reiniciosoftware1/LockPic/README.md

# LockPic
Programa cerradura para microcontrolador PIC
