reiniciosoftware1/LockPic/Trunk/Documentos/Circuito/Circuito_28P_V_1.1/LocPic_28P - CADCAM Mechanical 1.TXT

G04 PROTEUS RS274X GERBER FILE*
%FSLAX24Y24*%
%MOIN*%
%ADD24C,0.0080*%
G54D24*
X+0Y-866D02*
X+47559Y-866D01*
X+47559Y+21968D01*
X+0Y+21968D01*
X+0Y-866D01*
M00*
