reiniciosoftware1/LockPic/Trunk/Documentos/Circuito/Documentos/V_1_0/Documentacion.odt

TARJETA LOCKPICK V 1.0

CONTROL DE CAMBIOS DOCUMENTO VERSION 1.0.

19-04-2022 | Creacion primera version
29-04-2022 | Correcion parametros comunicacion y comandos
02-05-2022 | Inckuir ejemplo configuracion cerradura 3

# COMENTARIOS

1. Todos los pines pasadores entre capas se deben soldar primero, especialmente el que esta debajo del conector J1.
2. La puerta 1 es la de la boveda que se controla con el actuador negro.
3. La puerta 3 es la puerta de mantenimiento que se controla con el solenoide.

# FUENTES DE VOLTAJE

ID | ESPECIFICACIONES | DISPOSTIVOS CONECTADOS
F1 | 5V/2A | Tarjeta cerradura ( PIC, buzzer )
F2 | 12V/2A | Tarjeta cerradura ( Actuador y solenoide )
F3 | 24V/4A | Aceptador de billetes

IMPORTANTE todas las salidas -V ( 0VDC ) de las fuentes deben estar interconectadas para tener comun 0V.

# CONECTORES

ID | USO | PINES
J1 | Actuador cerradura negro | 1- Salida para dar orden al actuador de abrir puerta 2- Salida para dar orden al actuador de cerrar la puerta 3- Entrada para saber si el actuador esta en posicion de abierto 4- Entrada para saber si el actuador esta en posicion de cerrado 5- Salida para dar orden detener actuador 6- Salida sensor magnetico interno del actuador 7- Salida 12 VDC 8- Salida 0 VDC 9- Libre
J2 | Sensor bloqueada manija boveda | 1- Entrada pin comun del sensor 0V 2- Entrada pin NA del sensor
J3 | Sensor cerrada puerta boveda | 1- Entrada pin comun del sensor 0V 2- Entrada pin NA del sensor
J4 | Sensor bloqueada manija puerta mantenimiento ( DEBE ESTAR SOLDADO PERO NO SE USA) | 1- Entrada pin comun del sensor 0V 2- Entrada pin NA del sensor
J5 | Sensor cerrada puerta matenimiento | 1- Entrada pin comun del sensor 0V 2- Entrada pin NA del sensor
J6 | Salida para el solenoide de la puerta mantenimiento | 1- Salida +V 2- Salida -V
J7 | Fuentes de alimentacion | 1- Entrada 0 VDC 2- Entrada 5 VDC ( Alimenta el PIC) 3- Entrada 12 VDC ( Alimenta el actuador y el solenoide )
J8 | Comunicacion serial con el computador | 1- Salida 0 VDC. 2- Salida TX datos. 3- Entrada RX datos.

# CABLEADO

Los cables que van a sensores que detectan el estado de cerrado de las puertas o de las manijas, pueden ser magenticos o interruptores ( Finales de carrera ), en ambos casos los terminales usados son el Comun y el Normalmente abierto ( NA).

DESTINO EN LA TARJETA | USO | PINES
J1 | Actuador cerradura negro | Se solda cada cable segun el color en los pines del conector DB9 hembra: 1- Amarillo 2- Cafe 3- Verde 4- Azul 5- Blanco 6- Gris 7- Rojo 8- Negro 9- Libre
J2 | Sensor bloqueada manija boveda | 1- Comun del sensor 2- NA del sensor
J3 | Sensor cerrada puerta boveda | 1- Comun del sensor 2- NA del sensor
J4 | Sensor bloqueada manija puerta mantenimiento ( DEBE ESTAR SOLDADO PERO NO SE USA) | No esta instalado
J5 | Sensor cerrada puerta matenimiento | 1- Comun del sensor 2- NA del sensor
J6 | Salida para el solenoide de la puerta mantenimiento | 1- +V del solenoide ( Posiblemente cable rojo) 2- -V del solenoide ( Posiblemente cable negro )
J7 | Fuentes de alimentacion | 1- Cable a 0VDC comun de las fuentes. 2- Cable a +V fuende de 5 VDC 3- Cable a +V fuende de 12 VDC
J8 | Comunicacion serial con el computador | En el extremo que va al computador debe ir a un DB9 Hembra. 1- al pin 5 del DB9 ( es el 0V del computador) 2- al pin 2 del DB9 ( es el RX del computador) 3- al pin 3 del DB9 ( es el TX del computador).

# LISTA DE COMPONENTES

CANTIDAD | DETALLE | COMPRADA
1 | Base para integrado 28 pines | Sigma
1 | PIC 18F252 | Sigma
1 | Base para integrado 16 pines | Sigma
1 | Max 232CPE | Sigma
8 | Resistencias 10K - 1/4W
1 | Resistencia 1K - 1/4W | Sigma
1 | Resistencia 2.2K - 1/4W
1 | Resistencia 510 – 1/4W ( o valor mas cercano)
2 | Resistencia 330 - 1/4W
2 | Transistor BD136 | Sigma
1 | Transistor BD135
1 | Transistor TIP122
5 | Capacitores electroliticos 1uF ( 25V o 50V) | Sigma
2 | Capacitores ceramicos 22pF
2 | Capacitores ceramicos 100nF ( 104)
1 | Cristal 20MHz | Sigma
1 | Buzzer 5V o 9V ( Ver tamano quepa en el impreso) | Sigma
1 | LED 5mm ( El LED va con cables, NO soldado en el impreso ) | Sigma
1 | Porta LED 5mm para chasis ( En el local del segundo piso frente al que venden tornilleria venden unos metalicos como a $500 )
5 | Conectores verde para impreso de 2Pines | Sigma
2 | Conectores verdes para impreso de 3Pines | Sigma
1 | Conector DB9 Macho para impreso
5 | Conectores verdes para cable de 2pines | Sigma
2 | Conectores verde para cable de 2 pines | Sigma
1 | Conector DB9 Hembra para cable | Sigma
1 | Carcasa DB9 | Sigma
XX | Cable diferentes colores, teniendo encuenta que: El cable de comunicacion serial entre el computador y la tarjeta debe ser de 1metro de largo.
1 | Caja plastica para el impreso
4 | Juegos de soportes para impreso con tornillo y tuerca, para sujetar el impreso al piso de la caja
2 | Sensores magneticos o finales de carrera para detectar apertura de puertas
2 | Sensores magenticos o finales de carrera para detectar manija bloqueo de puertas.
15metro | Termo encogible de 3mm
15metro | Termo encogible de 5mm
15metro | Termo encogible de 8mm ( para proteger los cables )
1 paquete de 100 | Amarreplastico de 10cm ( aprox)

# PREPARACION

1. Verificacion antes de encender las fuente que no haya corto circuito.
2. Programar el PIC con la version del programa.
3. Instalar el PIC en la tarjeta y encender fuente de 5V y 12V.
4. Ejecutar el proceso de inicializacion de la cerradura.

# PRUEBAS

1. Cuando es energizada la tarjeta a 5V, el LED debe parpadear o quedar encendido.
2. Cuando es energizada la tarjeta a 5V el buzzer debe emitir un tono corto.
3. Ejecutar comando de apertura de puerta 1, debe bajar el pestillo del actuador negro
4. Ejecturar comando de cierre puerta 2, debe subir el pestillo del actuador negro
5. Ejecutar comando de apertura solenoide, debe contraerse el pestillo del solenoide por 3 Segundos y luego automaticamente volver a salir el pestillo.

# COMANDOS

Desde un computador con Windows, usando el programa Serial Port Utility, configurar el puerto serial a 9600 bps, 8bits, 1bit stop, paridad par ( Even ). Configurar transmision y recepcion de datos en formato HEX.

Luego conectar el cable serial entre la tarjeta y el computador y encender la fuente de 5V y 12V.

## INICIALIZACION DE LA CERRADURA

Cada vez que se programe el PIC se borra la memoria EEPROM donde esta la configuracion de las dos cerraduras, por lo que siempre luego de programado se debe ejecutar el siguiente proceso:

1. Enviar la trama: 03 08 42 00 73 01 02 03 04 3D
  Respuesta: 03 03 42 A0 E1
2. Enviar la trama: 03 08 42 02 73 01 02 03 04 3F
  Respuesta: 03 03 42 A0 E1

## APERTURA CERRADURAS

Para abrir la cerradura de la boveda, enviar el comando: 03 07 10 01 01 02 03 04 12

Respuesta: 03 03 10 A0 B3

Para abrir la cerradura de mantenimiento, enviar el comando: 03 07 10 03 01 02 03 04 10

Respuesta: 03 03 10 A0 B3

## CIERRE CERRADURAS

Para las cerraduras tipo solenoide se usa el mismo comando de apertura en caso de necesitar cerrar la puerta, aunque fisicamente solo con empujar la puerta el pestillo queda bloqueando la puerta.

Por otro lado, la cerradura de actuador lineal, requiere un comando diferente para que el pestillo salga y quede en la posicion de bloquear puerta, asi que el comando para cerrar la boveda es:

Enviar comando: 03 07 11 01 01 02 03 04 13

Respuesta: 03 03 10 A0 B3

## LECTURA SENSORES

La lectura del estado de los sensores, se obtiene al ejecutar el comando en el byte XX, donde cada bit representa el estado de cada sensor de la correspondiente puerta:

POSICION BIT | INTERPRETACION
7 | No usado
6 | No usado
5 | Para el actuador negro: 1- Pestillo adentro 0- Pestillo no adentro
4 | Para el actuador negro: 1- Pestillo completamente afuera 0- Pestillo no completo afuera
3 | No usado
2 | No usado
1 | Sensor de manija 1- Desbloqueada 0- Bloqueada
0 | Sensor puerta 1- Puerta abierta 0- Puerta cerrada

Para obtener el estado de los sensores puerta boveda enviar

comando: 03 05 20 01 22

Respuesta: 03 04 20 A0 XX B7

Para obtener el estado de los sensores de la puerta mantenimiento enviar

comando: 03 03 20 02 21

Respuesta: 03 04 20 A0 XX B7
