reiniciosoftware1/LockPic/Branches/README.md

# LockManager
Progama controlador de cerraduras
