reiniciosoftware1/LockPic/Trunk/Documentos/Diseno.odt

CERRADURA V2.0

Hay dos tipos de cerradura: A ( actuador lineal negro – Griego) B ( Lagart – Solenoide)

Cada cerradura tiene un conjunto de pines de salida para energizarla segun su logica de operacion, y otros pines para leer las señales de interruptores.

Cerradura tipo A: es la compuesta por el pestillo motorizado, que requiere mediante un pulso de 1 segundo la orden para entrar o sacar el pestillo. Adicionalmente dispone de dos salidas que reportan si el pestillo esta en la posicion de afuera o adentro.

Cuando se da un pulso ( 1 segundo ) para la orden de guardar o sacar el pestillo, se debe esperar hasta que las senales de posicion indiquen si ya llego a la posicio solicitada.

SEÑAL | SENTIDO | LOGICA | COMENTARIO
IA | A la cerradura | 0 ( 1seg): Pulso para iniciar guardar pestillo 1: No hay orden | Ordena guardar el pestillo
IB | A la cerradura | 0 ( 1 seg): Pulso iniciar sacar pestillo. 1: No hay orden | Orden sacar el pestillo
LI | Desde la cerradura | | Indicador pestillo guardado
LO | Desde la cerradura | | Indicador pestillo afuera

Cerradura tipo B: Esla compuesta por un solenoide que liebar el giro del pestillo, como funciona la de Lagard o la de solenoide. Este tipo de cerradura requiere mantener energisado durante el timepo suficiente para que se manualmente se gire el bloqueo del pestillo.

Maximo disponen de una senal que indica si el solenoide esta liberado o no.

SEÑAL | SENTIDO | LOGICA | COMENTARIO
IA | A la cerradura | 0 (X seg) desbloquar cerradura. 1: Matener bloqueda cerradura | Voltaje para polarizar el embobinado y permitir el giro del pestillo
LO | Desde la cerradura | 1: 0: | Indicador pestillo bloqueado

Cada puerta, dispone de uno de los tipo de cerradura para su bloqueo. Independientemente del tipo, una puerta dispone de dos senales de sensores, una para indicar si el mecanismo de bloqueo esta en posicion de bloqueo o de apertura ( SL), y otra senal para indicar el estado de la puerta, cerrada o abierta (SD).

SEÑAL | ESTADO | SIGNIFICADO
SL ( Senal bloqueo manija) | 1: Bloqueado mecanismo 0: Liberado mecanismo | Para las cerraduras tipo 1 que tienen manija que se debe jirar manual y tiene un sensor asociada a su posicion
SD (señal puerta ) | 1: Abierta 0: Cerrada | Señal generada por los sensores magenitocs o de interurptor que detectan si la puerta fisicamente esta abierta o abierta.

COMUNICACIONES

comunicacion serial RS232, con la configuracion : velocidad 9600bps, 8 bits de datos, 1 bit stop, paridad par.

PROTOCOLO

Estrucutra de cada frame establecida en el protocolo desde el controlador al PIC:

NOMBRE | LONGITUD ( bytes) | COMENTARIO
Encabezado | 1 | Byte 0x03
Longitud | 1 | Cantidad de bytes incluido los campos: Codigo, Datos, CRC.
Codigo | 1 | Codigo del comando a ejecutar
Datos | x | Bytes para la ejecucion del comando o respuesta.
CRC | 1 | CRC calculado como la operacion XOR entre todos los bytes de los campo Longitud, Codigo y Datos.

Estrucutra de cada respuesta establecida en el protocolo desde el PIC al Controlador:

NOMBRE | LONGITUD ( bytes) | COMENTARIO
Encabezado | 1 | Byte 0x03
Longitud | 1 | Cantidad de bytes incluido los campos: Codigo, Estado, Datos, CRC.
Codigo | 1 | Codigo del comando a responder
Estado operacion | 1 | Indica estado de la operación o codigo de error.
Datos | x | Bytes adicionales en al respuesta en caso que sean obtenidos la ejectura el comando
CRC | 1 | CRC calculado como la operacion XOR entre todos los bytes de los campo Longitud, Codigo, Estado y Datos.

MEMORIA EEPROM

La memoria EEPROM contiene las llaves de seguridad de cada cerradura, por lo que se usa un mapa especial de informacion.

El mapa contiene 6 bloques especiales para guardar llaves seguras, de los cuales los 3 primeros corresponden a las llaves para las cerraduras.

Cada bloque de llaves esta constituida por un grupo de 5 bytes, de los cuales el primer byte corresponde a las condiciones de acceso del bloque, los siguientes 4 bytes son el valor de la llave

BLOQUE | DIRECCIONES | USO
0 | 0x00 - 0x04 | Llave cerradura 1
1 | 0x05 - 0x09 | Llave cerradura 2
2 | 0x0A - 0x0E | Llave cerradura 3
3 | 0x0F - 0x13
4 | 0x14 - 0x18
5 | 0x19 - 0x1D
6 | 0x1E - 0x22 | Llave para autenticaion de token
7 | 0x23 - 0x27 | Tiempo ultimo token

Por defecto cuando el PIC es programado, la EEPROM es escrita con valores 0xFF, por lo que se toma

ese valor como bloque no inicializado.

Los datos en la memoria EEPROM se escriben en el orden que van llegando, siendo el offset incrementado por nuevo byte que se deba erscribir; estop corresponderia a que en la trama del comando escritura llave el byte de la posicion 5 seria el primer byte escrito en la direccion del bloque ( offset = 0 ).

Para operaciones matematicas, el byte del offset = 0, corresponde al byte de mayor peso de la llave.

Las condiciones de acceso solo es posible escribirlas solo si el bloque no esta inicializado ( condiciones acceso = 0xFF )

El byte de condiciones de acceso esta definido de la siquiente manera:

POSICION BIT | PERMISOS | COMENTARIO
0 | Lectura sin autenticacion | 0= Permitido leer 1= No permitido leer
1 | Escritura sin autenticacion | 0= permitido escribir 1= No permitido escribir
2 | Escritura con autenticacion | 0= permitido modificar el valor si previamente se confirma la llave actual. 1= No permite modificar este valor ni autenticandose
3 | Autenticacion | 0= Permite hacer el proceso de autenticacion de otro proceso usando esta llave. 1= No permite hacer proceso de autenticaicon de otro proceso usando esta llave
4
5
6
7 | Inicializar bloque | 1= Permite inicializar las condiciones de acceso y asignar el valor inicial de la llave. 0= permite modificar las condiciones de acceso del bloque previa autenticacion.

Segun el uso que se quiera dar a un bloque las condiciones de acceso deben ser:

CONDICIONES ACCESO (7-0) | OPERACIONES PERMITIDAS
1xxxxxxx | Permite formatear las condiciones de acceso sin autenticacion
01110011 | Permite formater el bloque para autenticar operaciones de apertura o cierre con la cerradura. Permite que se modifique la llave previa autenticacion.

Para hacer una operacion con la llaves, se tiene en el programa 2 buffer de memoria especificos para operaciones de intercambio de informacion:

- externalKey: Buffer de 4 bytes donde debe estar la llave de acceso en caso de reqeurirse autenticacion.
- ValueKey: Buffer de 4 bytes donde debe estar la nueva llave a escribir o la llave leida en la ultima operacion.
- indexBlock: Indice de la llave sobre la cual se va a ejecutar la operacion de escritura, lectura o autenticacion.
- AccessBlock: Condiciones de acceso en caso que se requiera este byte para una operacion

OPERACIONES EEPROM

Sobre la memoria se pueden hacer 3 operaciones: Lectura, escritura y autenticacion.Estas operaciones son posibles segun las condiciones de acceso de cada llave.

La operacion de autenticacion tiene como proposito validar una llave externa contra la llave guardada en el sector, y en caso de coincidir autorizar un posterior proceso.

En caso que una operacion que requiera llave de seguridad falle consecutivamente 3 veces o mas, el PIC entra en modo bloqueo temporal, generando que ignore cualquie comando por un lapso de 5 minutos. Esto para evitar un ataque de fuerza bruta pretendiendo abrir un apuerta.

TOKEN OPERACIONES

Las operaciones de apertura o cierre de cerraduras, son verificadas con un token adicional que debe enviarse con cada uno de estos comandos, solo hasta que el token sea comprobado se procede a activar los correspondientes pines de la cerradura solicitada.

El token es el tiempo transcurrido en segundos desde el 1 enero del 2000, por lo cual cada nueva orden que requiera token debe enviar un tiempo mayor al del comando previo ejecutado. Este tiempo se guarda a partir de la direccion 0x21 de la memoria EEPROM del PIC, donde el byte de mayor peso queda en el offset 0; si el tiempo de un token enviado es inferior o igual al que se tiene en la memoria, el comando es rechazado, si por el contrario el tiempo recibido es mayor al guardado, se ejecuta la orden y se actualiza el nuevo tiempo en la memoria. Esto garantiza que no se envie el mismo token para dos comandos.

En la posicion 0x20 de la memoria EEPROM se guarda el byte de bloqueo, para identificar si es la primera vez que se va a escribir el tiempo, ya que cuando se programa el PIC toda la EEPROM queda en 0xFF, asi que si se encuentra el byte de bloqueo en ese valor, se escribe el tiempo recibido directamente en la memoria y posteriormente se cambia el byte de bloqueo a 0x00, a partir de ese momento todas las oepraciones de escritura de tiempo validan que el nuevo valor sea mayor al actualmente en la memoria.

Adicionalmente, para evitar una escritura de token por fuerza bruta, se limita a maximo 3 errores de token consecutivo, luego de esto se cambia amodo retrazo de 5 minutos por cada nuevo comando.

Para codificar el token se requieren los siguientes valores:

R= dato de 4 bytes generados aleatoriamente. R0 ES EL VALOR EXTREMO DERECHA.

D= NOT ( T – K ), donde T es el tiempo en segundos calculado y K es la llave de la cerradura 1 ( bloque 0 ).

SH= R2 + D0 + ( K3 + K2 ) Truncado a 1B.

SL= R1 + D0 + ( K1 + K0 ) Truncado a 1B.

El token consta de un valor de 10 bytes dispuesto de la siguiente manera:

SH | R0 | D1 + R2 | R1 | D3 + R0 | R2 | D0 + R3 | R3 | D2 + R1 | SL

Ejemplo:

Asumiendo que T = 393984000 segundos = 0x177BB800

K = 0x01020304

R = 0xF0A8CD63

D = NOT ( 0x177BB800 - 0x01020304 ) = 0xE9864B03

SH = 0xA8 + 0x03 + ( 0x01 + 0x02 ) = 0xAE

SL = 0xCD + 0x03 + ( 0x03 + 0x04 ) = 0xD7

TOKEN = 0xAE63F3

Logicamente, cada comando que requiera un envio de token, dee usar la llave del bloque de la opearcion a efectuar como la llave para generar el token, asi por ejkemplo si se quiere formatear el bloque 1 se debe usar la llave definida para ese bloque; igualmente si se quiere abrir una cerradura se debe usar la correspondiente llave para calcular el token que se envia en el token.

COMANDOS

COMANDO | DATOS | RESPUESTA | COMENTARIO
Apertura cerradura 0x10 | Id: 1B llave:4B | 0xA0: Operacion ejecutada 0xF0: Error bloque sin inicializar. 0xF1: Error condiciones acceso 0xF2: Error llave 0xE0:Error formato 0xE1:Error CRC 0xE2:Error comando desconocido 0xE3: Error de valor 0xE4: Error numero datos | Id: Numero de cerradura ( 1,2,3) llave:N4 bytes de llave para autenticar la operacion
Bloqueo cerradura 0x11 | Id: 1B llave:4B | 0xA0: Operacion ejecutada 0xF0: Error bloque sin inicializar. 0xF1: Error condiciones acceso 0xF2: Error llave 0xE0:Error formato 0xE1:Error CRC 0xE2:Error comando desconocido 0xE3: Error de valor 0xE4: Error numero datos | Id: Numero de cerradura ( 1,2,3) llave:N4 bytes de llave para autenticar la operacion
Apertura cerradura V2 0x12 | Id: 1B llaveRandom:4B Token: 10B | 0xA0: Operacion ejecutada 0xF0: Error bloque sin inicializar. 0xF1: Error condiciones acceso 0xF2: Error llave 0xF3: Error token 0xF4: Error tiempo 0xE0:Error formato 0xE1:Error CRC 0xE2:Error comando desconocido 0xE3: Error de valor 0xE4: Error numero datos | Id: Numero de cerradura ( 1,2,3) llaveRandom:N4 bytes de llave para autenticar la operacion sumado a dato random generado para el token byte a byte.
Bloqueo cerradura V2 0x13 | Id: 1B llaveRandom:4B Token: 10B | 0xA0: Operacion ejecutada 0xF0: Error bloque sin inicializar. 0xF1: Error condiciones acceso 0xF2: Error llave 0xF3: Error token 0xF4: Error tiempo 0xE0:Error formato 0xE1:Error CRC 0xE2:Error comando desconocido 0xE3: Error de valor 0xE4: Error numero datos | Id: Numero de cerradura ( 1,2,3) llaveRandom:N4 bytes de llave para autenticar la operacion sumado al dato random del token byte a byte.
Escritura EEPROM 0x40 | Pos:1B Dato: 1B | 0xA0: Operacion ejecutada 0xE0:Error formato 0xE1:Error CRC 0xE2:Error comando desconocido 0xE4: Error numero datos | Pos: Direccion dentro de la memoria EEPROM. Dato: Byte a escribir. Comando usado apra recuperacion por perdida de llave
Formatear bloque 0x42 | Id:1B Condiciones:1B llave: 4B | 0xA0: Operacion ejecutada 0xF1: Error condiciones acceso 0xF2: Error llave 0xE0:Error formato 0xE1:Error CRC 0xE2:Error comando desconocido 0xE3: Error de valor 0xE4: Error numero datos | Id: Numero de bloque a escribir ( 0 – 7) Condiciones: Byte de condiciones de aceso. Llave: Llave de seguridad.
Cambiar llave 0x43 | Id:1B llaveRandom: 4B token:10B | 0xA0: Operacion ejecutada 0xF1: Error condiciones acceso 0xF2: Error llave 0xF3: Error token 0xF4: Error tiempo 0xE0:Error formato 0xE1:Error CRC 0xE2:Error comando desconocido 0xE3: Error de valor 0xE4: Error numero datos | Id: Numero de bloque a escribir ( 0 – 7) LlaveRandom: Llave de seguridad sumada a numero random. Token: Token seguridad. Dependiendo de las condiciones de acceso, se permite escribir la llave. Si se tiene activo el permiso de escritura sin autenticacion, los 4 bytes de la llave deben ser sin random, es decir directos. Si se tiene el permiso de escritura con autenticacion, se valida el token y si es correcto se obtiene de la llave random la llave real, la cual se escribe en memoria.
Formatear bloque V2 0x44 | Id:1B Condiciones:1B llaveRandom: 4B Token: 10B | 0xA0: Operacion ejecutada 0xF1: Error condiciones acceso 0xF2: Error llaves 0xF3: Error token 0xF4: Error tiempo 0xE0:Error formato 0xE1:Error CRC 0xE2:Error comando desconocido 0xE3: Error de valor 0xE4: Error numero datos | Id: Numero de bloque a escribir ( 0 – 7) Condiciones: Byte de condiciones de aceso. LlaveRandom: Llave de seguridad + randomico. Token: Token randomico. Si es la primera vez que se formatea el bloque, la llave de seguridad se escribe com ola llave de acceso al bloque. La llave usada para el token debe ser la lalve para validacion de token. Si el bloque ya esta inicializado, la llave de seguridad no es escrita, pero si comparada con la llave actual del bloque para permitir el cambio de permisos del bloque. Si se quiere cambiar la lalve del bloque se debe usaar el coamdno de cambio de llave.
Estado sensores 0x20 | Id: 1B | 0xE0:Error formato 0xE1:Error CRC 0xE2:Error comando desconocido 0xE3: Error de valor 0xE4: Error numero datos | Id: Numero de cerradura a obtener lectura sensores (1, 2, 3)
Version 0x50 | | 0xA0: Operacion ejecutada VersionHB VersionLB 0xE0:Error formato 0xE1:Error CRC 0xE2:Error comando 0xE4: Error numero datos | Obtiene la version del software donde cada nible de la respuesta es un digito de l aversion, por ejemplo la version 1.0.1 se codifica como 0101
Buzzer 0x52 | Dato:1B | 0xA0: Operacion ejecutada 0xE0:Error formato 0xE1:Error CRC 0xE2:Error comando 0xE4: Error numero datos | Valor en factores de 10ms para encenderse el buzzer
Cashbox 0x60 | | 0xA0: Operacion ejecutada 1B estado sensor 0xE0:Error formato 0xE1:Error CRC 0xE2:Error comando 0xE4: Error numero datos | Obtiene el estado del sensor del cashbox
Poll 0x70 | | 0xA0: Operacion ejecutada 2B estado proceso 0xE0:Error formato 0xE1:Error CRC 0xE2:Error comando 0xE4: Error numero datos | Poll a la tarjeta
SetToken 0x80 | Token:10B | 0xA0: Operacion ejecutada 0xF3: Error token 0xF4: Error tiempo 0xE0:Error formato 0xE1:Error CRC 0xE2:Error comando 0xE4: Error numero datos | Asigna un tiempo de token en la memoria EEPROM.

ESTADO SENSORES

La lectura de los sensores, se hace por cada puerta en particular, donde se obtiene un byte de respuesta que indica el nivel logico leido. Segun el tipo de cerradura (A o B) se tiene la siguiente informacion de sensores:

Num bit | TIPO A | TIPO B
7 | 0 | 0
6 | 0 | 0
5 | LI | 0
4 | LO | 0
3 | 0 | 0
2 | 0 | 0
1 | 0 (cambio V1.0.1) | SL
0 | SD | SD

En la version 1.0.1, la cerradura tipo B se le quito el pin destinado a SL para reasignarlo al estado de la bolsa lata.

EJEMPLO TRAMAS

Asignar token nuevo

TX (Hex ) = 03 0C 80 AE 63 4B CD E9 A8 03 F0 86 D7 24

RX (Hex ) = 03 03 42 A0 E1

Hacer poll

TX (Hex ) = 03 02 70 72

RX (Hex ) = 03 05 70 A0 00 00 D5

LECTURA VERSION

Tx (Hex) = 03 02 50 52

RX (Hex ) = 03 05 50 A0 01 01 FA

Apertura cerradura 1 token random =0x5B0E900F, key=0x01020304

TX (Hex ) = 03 11 12 01 5C 10 93 13 AB 0F F1 90 D6 0E 9A 5B 4F 31 6C

Bloquear cerradura 1 token random =0x5B0E900F, key=0x01020304

TX (Hex ) = 03 11 13 01 5C 10 93 13 AB 0F F1 90 D6 0E 9A 5B 4F 31 6D

ACTIVACION BUZZER

Tx (Hex) = 03 03 52 64 35

Tx (Hex) = 03 03 52 A0 F0

LECTURA SENSOR CASHBOX

Tx (Hex) = 03 02 60 62

Tx (Hex) = 03 04 60 A0 00 C4

CERRADURA 1 TIPO A

Trama inicializar llave 1

TX (Hex ) = 03 08 42 00 73 01 02 03 04 3D

RX (Hex ) = 03 03 42 A0 E1

PRUEBA INTENTO CAMBIAR CONDICIONES ACCESO ERRADO

TX (Hex ) = 03 08 42 00 73 01 00 03 04 3F

RX (Hex ) = 03 03 42 F2 E1

INICIALIZAR V2 llave 0x01020304 random 0x11121314

TX (Hex ) = 03 12 44 00 73 12 14 16 18 FF FF FF FF FF FF FF FF FF FF FF

RX (Hex ) = 03 03 42 A0 E1

CAMBIO LLAVE 1 Kvieja= 0x01020304 Knueva= 0x2021222324 Random= 0x5B0E900F

Tx ( Hex ) = 03 11 43 00 7B 2F B2 32 AB 0F F1 90 D6 0E 9A 5B 4F 31 24

RX (Hex ) =03 03 43 A0 E0

Abrir cerradura 1 con llave 01020304

Tx (Hex) = 03 07 10 01 01 02 03 04 12

RX (Hex ) =03 03 10 A0 B3

ERROR LLAVE Abrir cerradura 1 con llave FFFFFFFF

Tx (Hex) = 03 07 10 01 FF FF FF FF 16

Cerrar cerradura 1 con llave 01020304

Tx (Hex) = 03 07 11 01 01 02 03 04 13

RX (Hex ) = 03 03 11 A0 B2

Consulta sensores cerradura 1

Tx (Hex) = 03 03 20 01 22

RX (Hex ) = 03 04 20 A0 33 B7

CERRADURA 2 TIPO A

Trama inicializar llave 2

TX (Hex ) = 03 08 42 01 73 05 06 07 08 34

RX (Hex ) = 03 03 42 A0 E1

Abrir cerradura 2 con llave 05 06 07 08

Tx (Hex) = 03 07 10 02 05 06 07 08 19

RX (Hex ) =03 03 10 A0 B3

Cerrar cerradura 2 con llave 05060708

Tx (Hex) = 03 07 11 02 05 06 07 08 18

RX (Hex ) = 03 03 11 A0 B2

Consulta sensores cerradura 2

Tx (Hex) = 03 03 20 02 21

RX (Hex ) = 03 04 20 A0 33 B7

PARA CERRADURA 3 tipo B

Trama inicializar llave 3

TX (Hex ) = 03 08 42 02 73 01 02 03 04 3F

RX (Hex ) = 03 03 42 A0 E1

Abrir cerradura 3 con llave 01020304

Tx (Hex) = 03 07 10 03 01 02 03 04 10

RX (Hex ) = 03 03 10 A0 B3

Cerrar cerradura 3 con llave 01020304

Tx (Hex) = 03 07 11 03 01 02 03 04 11

RX (Hex ) = 03 03 11 A0 B2

Consulta sensores cerradura 3

Tx (Hex) = 03 03 20 03 20

RX (Hex ) = 03 04 20 A0 33 B7

ESCRITURA DATOS EEPROM

Escritura valor 0xFF en al direccion 0x00

Tx (Hex) = 03 04 40 00 FF BB

RX (Hex ) = 03 03 40 A0 E3

VERSION 2 PROCESO

Con el PIC programdo y con la memoria EEPROM toda en 0xFF

1. Asignar la llave de token usando el comando initblock, este comadno escribe la llave de token y el primer valor de tiempo para token.
2. Formatear el bloque 0 con la llave de la cerradura 1 ( llave + random) y generando el token con la llave token.
3. Formatear el bloque 1 con la llave cerradura 2 ( llave + random) y generando el token con la llave token.
4. Formatear el bloque 2 con la llave cerradura 3 ( llave + random) y generando el token con la llave token.
