reiniciosoftware1/LockPic/Trunk/Documentos/BANDERAS DE PROGRAMACION.jpg

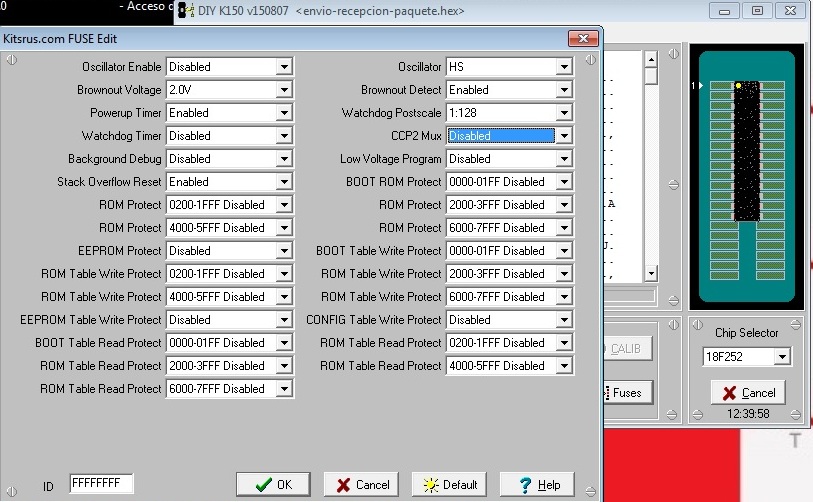
Trunk/Documentos/BANDERAS DE PROGRAMACION.jpg
