reiniciosoftware1/LockPic/Trunk/Documentos/Circuito/Circuito_28P_V_1.1/circuito.bmp

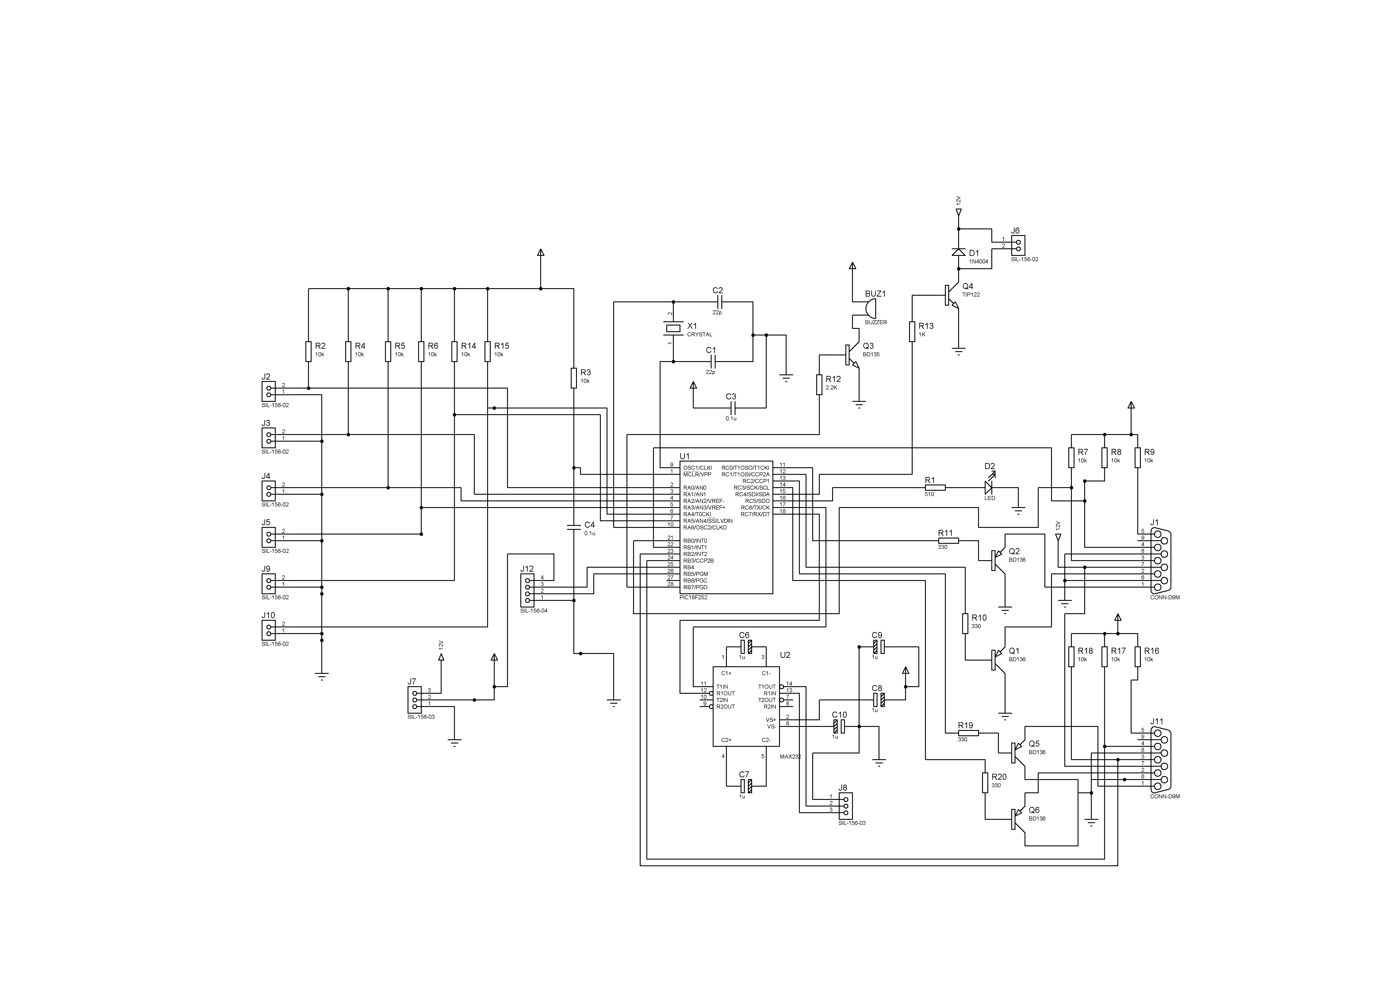
Trunk/Documentos/Circuito/Circuito_28P_V_1.1/circuito.bmp
