reiniciosoftware1/LockPic/Trunk/Documentos/Circuito/Circuito_28P_V_1.1/LocPic_28P - CADCAM Bottom Solder Resist.TXT

G04 PROTEUS RS274X GERBER FILE*
%FSLAX24Y24*%
%MOIN*%
%ADD18C,0.0500*%
%ADD25R,0.0900X0.0900*%
%ADD26C,0.2900*%
%ADD15R,0.0700X0.0700*%
%ADD20C,0.0700*%
%ADD27C,0.1400*%
%ADD28C,0.1000*%
%ADD70C,0.0800*%
%ADD21C,0.0900*%
%ADD29C,0.1100*%
%ADD72R,0.1000X0.1000*%
%ADD73R,0.0950X0.0950*%
%ADD24C,0.0080*%
G54D18*
X+25448Y+9827D03*
X+26220Y+9881D03*
X+18564Y+7008D03*
X+20590Y+16023D03*
X+14719Y+17076D03*
X+10237Y+14979D03*
X+13655Y+16819D03*
X+6255Y+15210D03*
X+4465Y+12942D03*
X+32077Y+17508D03*
X+28818Y+15944D03*
X+33267Y+13622D03*
X+37496Y+14251D03*
X+33601Y+8572D03*
X+23503Y+13385D03*
X+30540Y+4269D03*
X+26771Y+15039D03*
X+20579Y+4509D03*
X+30501Y-133D03*
X+22716Y+3385D03*
X+32244Y+511D03*
X+24645Y+3523D03*
X+39377Y+14145D03*
X+23661Y+3425D03*
X+37559Y+17401D03*
X+15275Y+20669D03*
X+42059Y+18591D03*
X+35118Y+13425D03*
X+35375Y+7952D03*
X+18651Y+8113D03*
X+9133Y+12974D03*
G54D25*
X+16887Y+18822D03*
X+15807Y+18822D03*
X+14727Y+18822D03*
X+13647Y+18822D03*
X+12567Y+18822D03*
X+16347Y+19822D03*
X+15267Y+19822D03*
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
