reiniciosoftware1/LockPic/Trunk/Documentos/Circuito/Documentos/V_1_0/componentes_capa.pdf

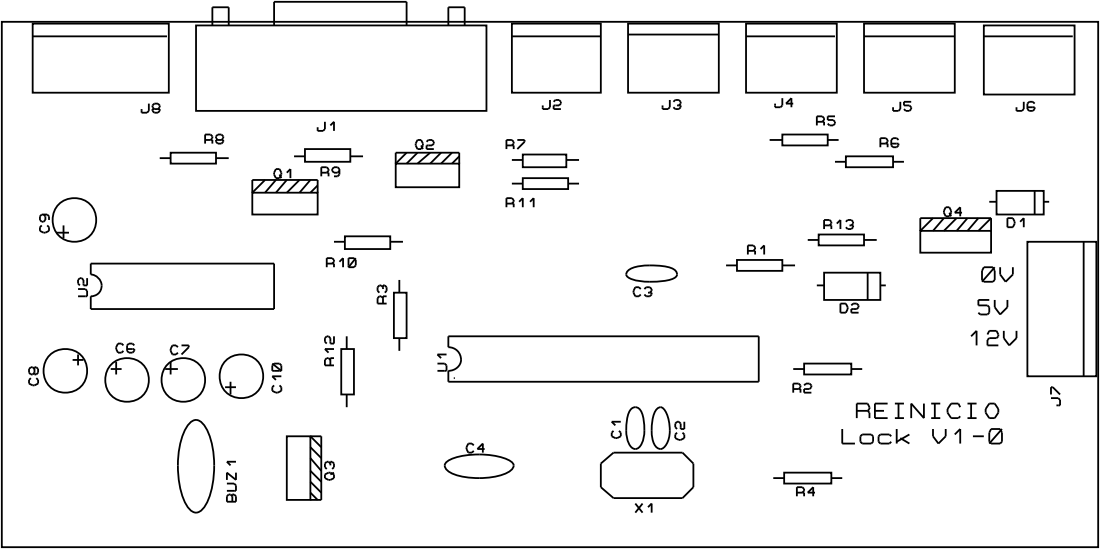
[picture p3: page 1]
