reiniciosoftware1/LockPic/Trunk/Documentos/Circuito/Documentos/V_1_0/bottom_capa.pdf

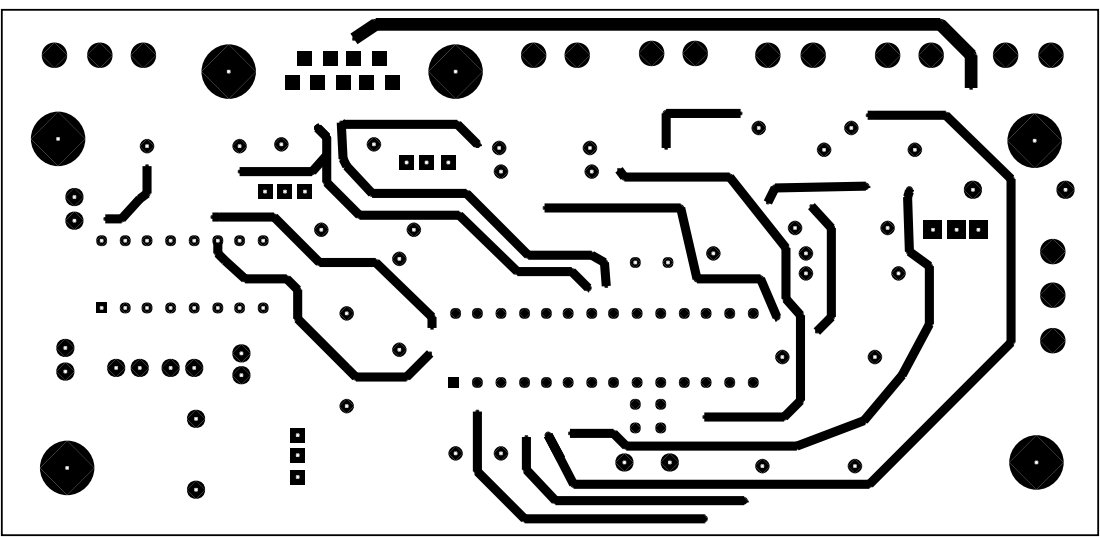
[picture p4: page 1]
