reiniciosoftware1/LockPic/Trunk/Documentos/Circuito/Documentos/V_1_0/plano.pdf

D1

X1

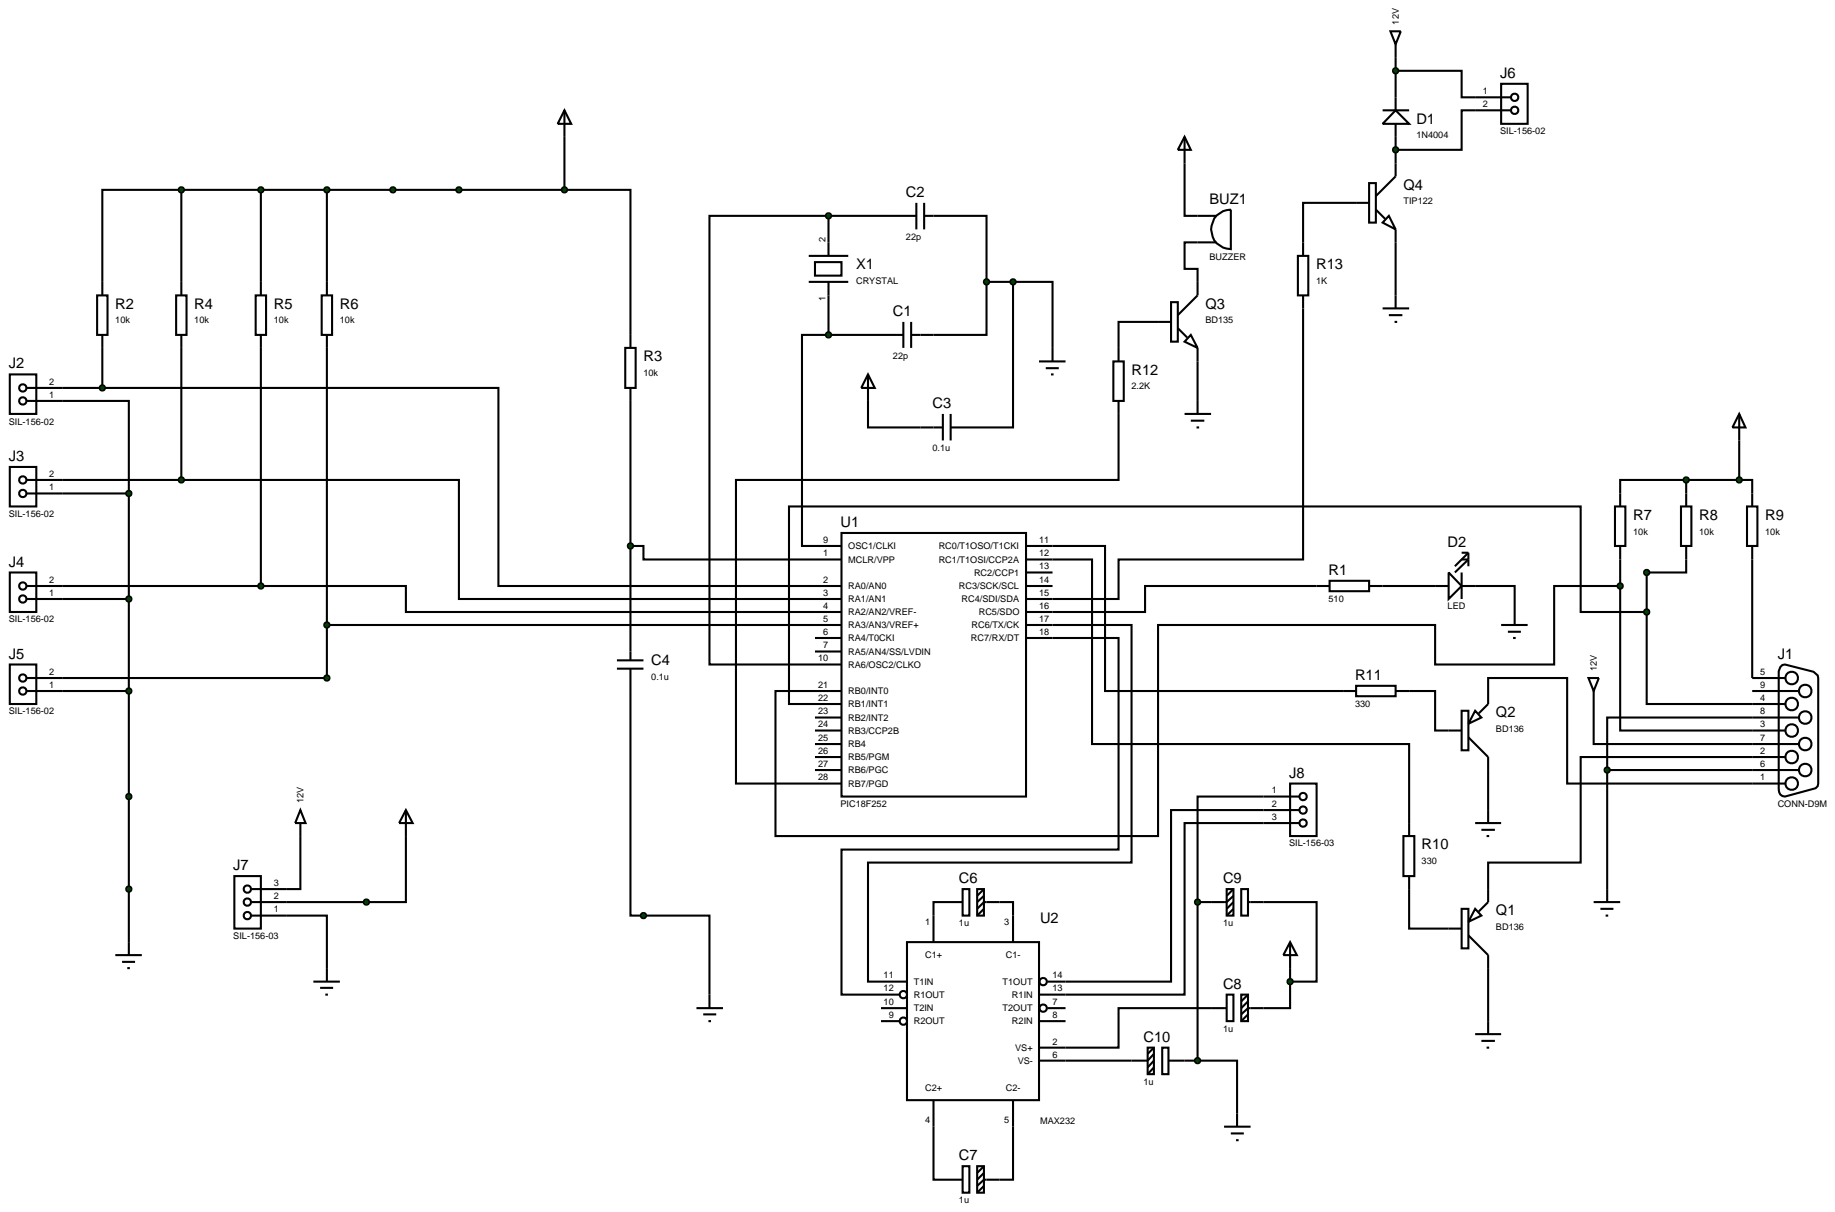
[picture p5: page 1]
