reiniciosoftware1/LockPic/Trunk/Documentos/Circuito/Documentos/V_1_0/top_capa.pdf

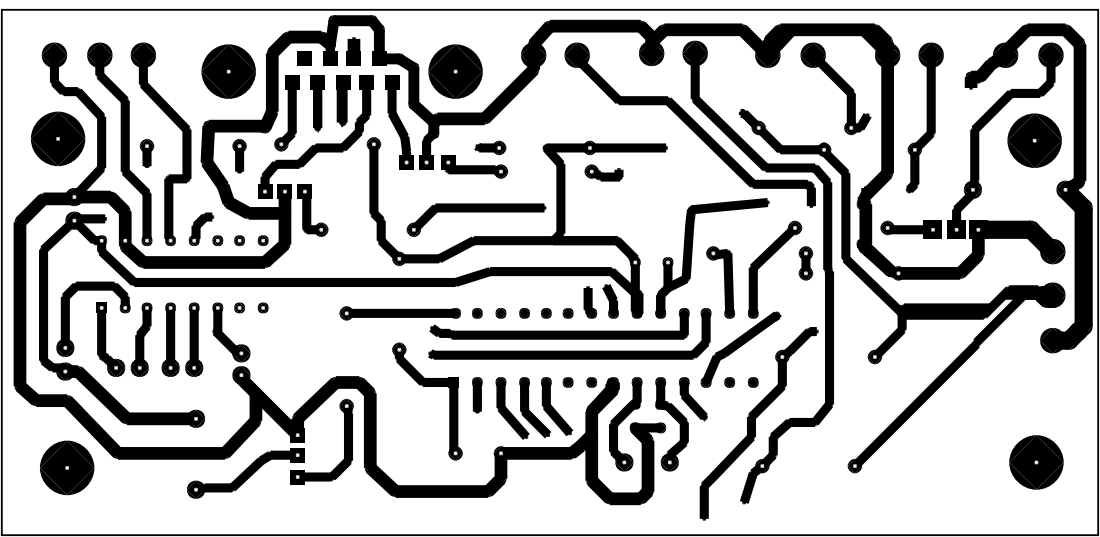
[picture p6: page 1]
