reiniciosoftware1/LockPic/(list of files, drawings)

Other design files:
Trunk/Documentos/Circuito/Circuito_28P_V_1.1/LocPic_28P.pdsprj
Trunk/Documentos/Circuito/Circuito_28P_V_1_0/LocPic_28P.pdsprj
