reiniciosoftware1/LockPic/Trunk/Resource/Test_Pic/Main.h

/*
 * Main.h
 *
 *  Created on: 07/09/2022
 *      Author: german
 */

#ifndef MAIN_H_
#define MAIN_H_

#include <pthread.h>
#include "CPic.h"
#include "CFile.h"


/*!
 * \file
 * \brief Archivo cabecera para el proceso principal para el MoneyManager V2
 */

/************************************************************************
* PROYECTO: Test Pic
*~~~~~~~~~~~~~~~~~~~~~~~~~~~~~~~~~~~~~~~~~~~~~~~~~~~~~~~~~~~~~~~~~~~~~~~~
*
*                            DECLARACION DE
*      CONSTANTES, MACROS, TIPOS, PROTOTIPOS, Y VARIABLES GLOBALES
*                       UTILIZADOS EN EL PROYECTO
*
* svnId="$Id$"
************************************************************************

       /********************************************************
        *          Declaracion de Constantes y Macros           *
        ********************************************************/

// Definicion de la version del firmware


        /********************************************************
        * Declaracion de struct's, enum's, union's y typedef's  *
        ********************************************************/


        /********************************************************
        *         Prototipos de las funciones globales          *
        ********************************************************/



        /********************************************************
        *           Declaracion de variables globales           *
        ********************************************************/

CPic * objPic;        
CFile * objFile;


#endif /* MAIN_H_ */
